kb-elmo/BM42/plates/README.md

# BM42 plate

---

This plate is meant to fit into the BM43 case together with the custom PCB.

The possible layouts are listed below.

#### BM42 plate
bmplate
