kb-elmo/BM42/plates/bm42_plate.dxf

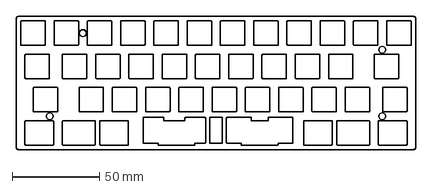
[picture p3: CAD file, 2022-03-03]
plates/bm42_plate.dxf
228.6 x 76.2 mm
