kb-elmo/BM42/pcb/bm42.kicad_sch

## KiCad design pcb/bm42.kicad_sch (2022-03-03)

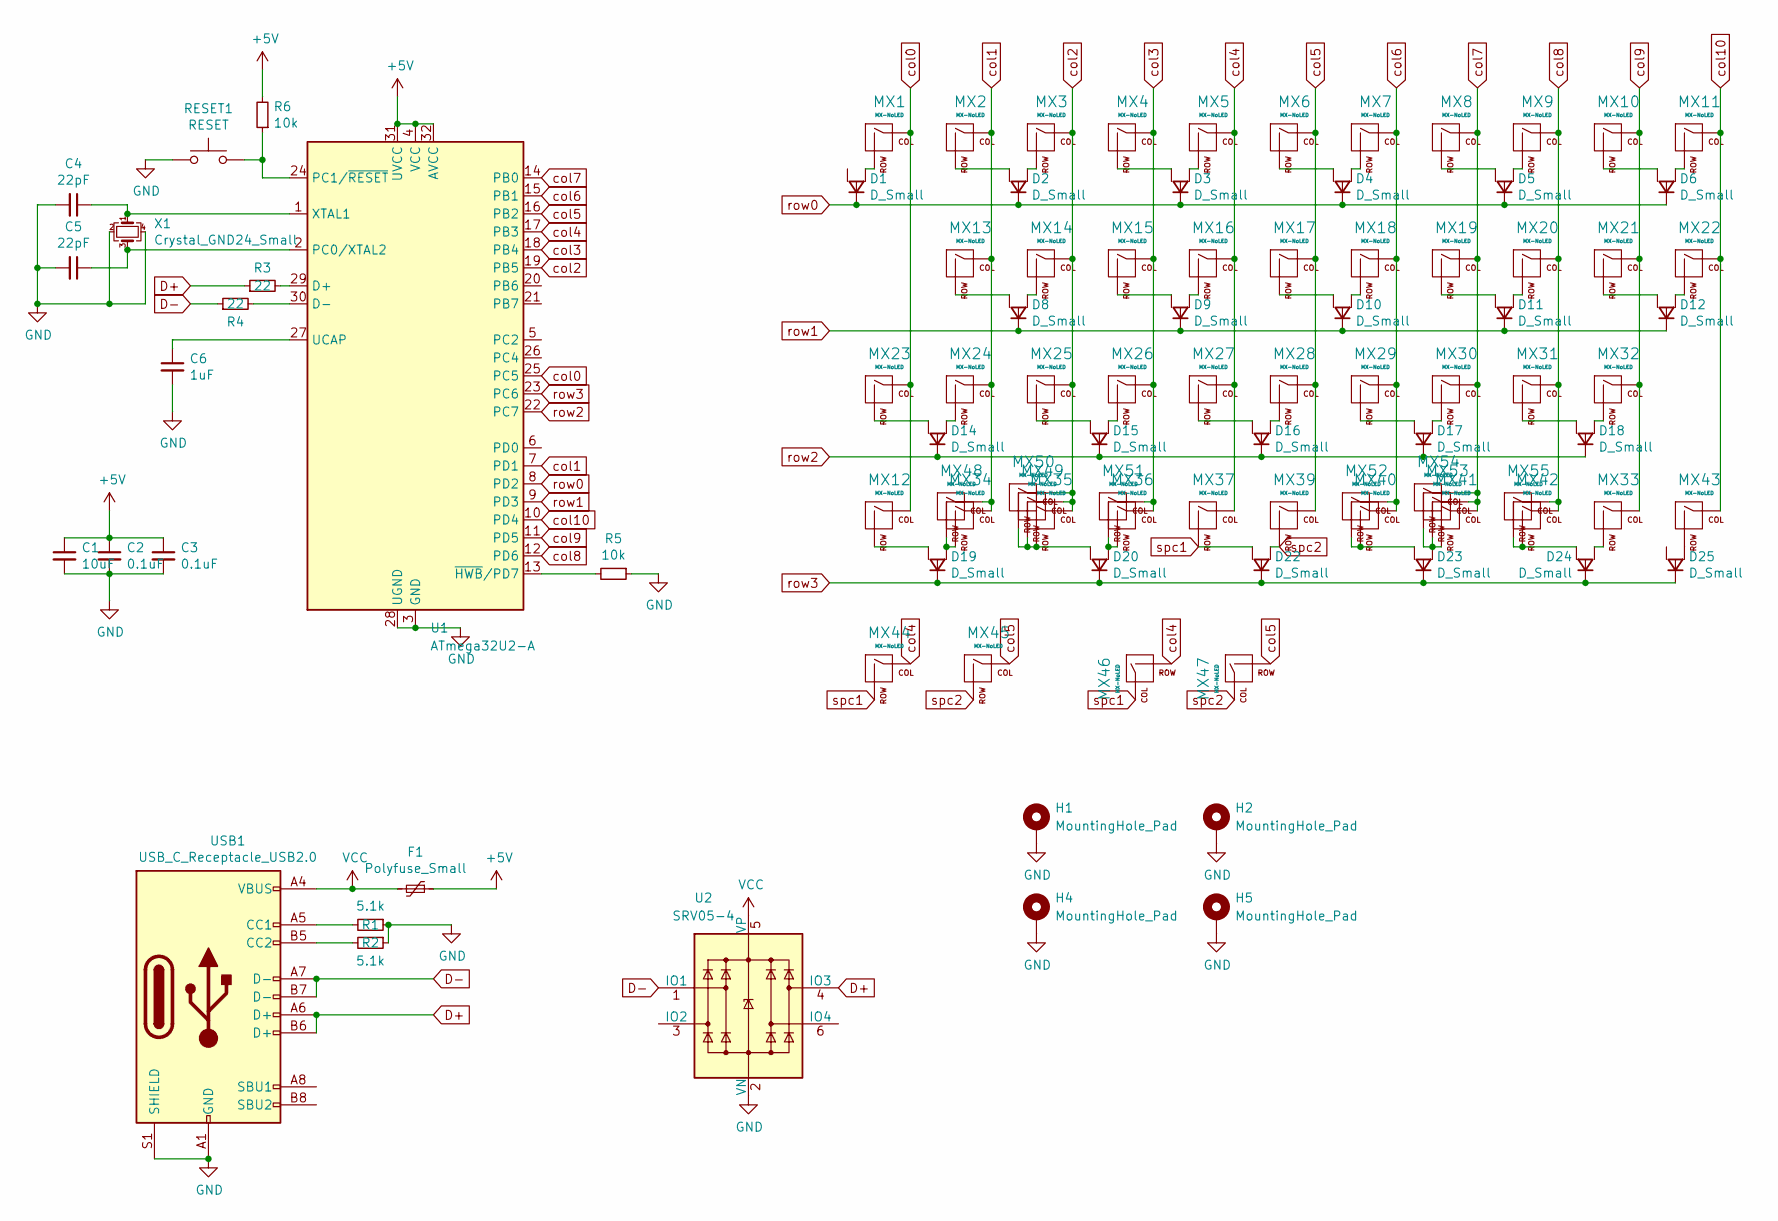
[picture p4: schematic bm42.kicad_sch]

Parts:
C1: 10uF; C_0805_2012Metric; LCSC C91245
C2, C3: 0.1uF; C_0805_2012Metric; LCSC C49678
C4, C5: 22pF; C_0805_2012Metric; LCSC C1804
C6: 1uF; C_0805_2012Metric; LCSC C24123
D1, D2, D3, D4, D5, D6, D8, D9, D10, D11, D12, D14, D15, D16, D17, D18, D19, D20, D22, D23, D24, D25: D_Small; D_SOT-23_ANK_norm; LCSC C68978
F1: Polyfuse_Small; Fuse_1206_3216Metric; LCSC C69688
H1, H2, H4, H5: MountingHole_Pad; MountingHole_2.2mm_M2_DIN965_Pad
MX1, MX2, MX3, MX4, MX5, MX6, MX7, MX8, MX9, MX10, MX11, MX13, MX14, MX15, MX16, MX17, MX18, MX19, MX20, MX21, MX24, MX25, MX26, MX27, MX28, MX29, MX30, MX31, MX32, MX35, MX41, MX43, MX50, MX51, MX52, MX54: MX-NoLED; MXOnly-1U-NoLED
MX12, MX33, MX34, MX36, MX40, MX42, MX49, MX53: MX-NoLED; MXOnly-1.25U-NoLED
MX22, MX23: MX-NoLED; MXOnly-1.75U-NoLED
MX37: MX-NoLED; MXOnly-3U-ReversedStabilizers-NoLED
MX39: MX-NoLED; MXOnly-2U-ReversedStabilizers-NoLED
MX44, MX47: MX-NoLED; MXOnly-2.75U-ReversedStabilizers-NoLED
MX45, MX46: MX-NoLED; MXOnly-2.25U-ReversedStabilizers-NoLED
MX48, MX55: MX-NoLED; MXOnly-1.5U-NoLED
R1, R2: 5.1k; R_0805_2012Metric; LCSC C27834
R3, R4: 22; R_0805_2012Metric; LCSC C17561
R5, R6: 10k; R_0805_2012Metric; LCSC C17414
RESET1: RESET; PinHeader_1x02_P2.54mm_Vertical
U1: ATmega32U2-A; TQFP-32_7x7mm_P0.8mm; LCSC C618733
U2: SRV05-4; SOT-23-6; LCSC C85364
USB1: USB_C_Receptacle_USB2.0; USB_C_Receptacle_HRO_TYPE-C-31-M-12; LCSC C165948
X1: Crystal_GND24_Small; Crystal_SMD_3225-4Pin_3.2x2.5mm; LCSC C13738

Connections:
+5V: C1.1, C2.1, C3.1, F1.1, R6.2, U1.4 (VCC), U1.31 (UVCC), U1.32 (AVCC)
D+: R3.1, U2.4 (IO3), USB1.A6 (D+), USB1.B6 (D+)
D-: R4.1, U2.1 (IO1), USB1.A7 (D-), USB1.B7 (D-)
GND: C1.2, C2.2, C3.2, C4.2, C5.2, C6.2, H1.1, H2.1, H4.1, H5.1, R1.1, R2.1, R5.1, RESET1.1, U1.3 (GND), U1.28 (UGND), U2.2 (VN), USB1.A1 (GND), USB1.A12 (GND), USB1.B1 (GND), USB1.B12 (GND), USB1.S1 (SHIELD), X1.2, X1.4
unnamed: C4.1, U1.1 (XTAL1), X1.1
unnamed: C5.1, U1.2 (PC0/XTAL2), X1.3
unnamed: C6.1, U1.27 (UCAP)
unnamed: D1.3 (A2), MX1.2 (ROW)
unnamed: D2.2 (A1), MX2.2 (ROW)
unnamed: D2.3 (A2), MX3.2 (ROW)
unnamed: D3.2 (A1), MX4.2 (ROW)
unnamed: D3.3 (A2), MX5.2 (ROW)
unnamed: D4.2 (A1), MX6.2 (ROW)
unnamed: D4.3 (A2), MX7.2 (ROW)
unnamed: D5.2 (A1), MX8.2 (ROW)
unnamed: D5.3 (A2), MX9.2 (ROW)
unnamed: D6.2 (A1), MX10.2 (ROW)
unnamed: D6.3 (A2), MX11.2 (ROW)
unnamed: D8.2 (A1), MX13.2 (ROW)
unnamed: D8.3 (A2), MX14.2 (ROW)
unnamed: D9.2 (A1), MX15.2 (ROW)
unnamed: D9.3 (A2), MX16.2 (ROW)
unnamed: D10.2 (A1), MX17.2 (ROW)
unnamed: D10.3 (A2), MX18.2 (ROW)
unnamed: D11.2 (A1), MX19.2 (ROW)
unnamed: D11.3 (A2), MX20.2 (ROW)
unnamed: D12.2 (A1), MX21.2 (ROW)
unnamed: D12.3 (A2), MX22.2 (ROW)
unnamed: D14.2 (A1), MX23.2 (ROW)
unnamed: D14.3 (A2), MX24.2 (ROW)
unnamed: D15.2 (A1), MX25.2 (ROW)
unnamed: D15.3 (A2), MX26.2 (ROW)
unnamed: D16.2 (A1), MX27.2 (ROW)
unnamed: D16.3 (A2), MX28.2 (ROW)
unnamed: D17.2 (A1), MX29.2 (ROW)
unnamed: D17.3 (A2), MX30.2 (ROW)
unnamed: D18.2 (A1), MX31.2 (ROW)
unnamed: D18.3 (A2), MX32.2 (ROW)
unnamed: D19.2 (A1), MX12.2 (ROW)
unnamed: D19.3 (A2), MX34.2 (ROW), MX48.2 (ROW)
unnamed: D20.2 (A1), MX35.2 (ROW), MX49.2 (ROW), MX50.2 (ROW)
unnamed: D20.3 (A2), MX36.2 (ROW), MX51.2 (ROW)
unnamed: D23.2 (A1), MX40.2 (ROW), MX52.2 (ROW)
unnamed: D23.3 (A2), MX41.2 (ROW), MX53.2 (ROW), MX54.2 (ROW)
unnamed: D24.2 (A1), MX33.2 (ROW)
unnamed: D24.3 (A2), MX42.2 (ROW), MX55.2 (ROW)
unnamed: D25.3 (A2), MX43.2 (ROW)
unnamed: R1.2, USB1.A5 (CC1)
unnamed: R2.2, USB1.B5 (CC2)
unnamed: R3.2, U1.29 (D+)
unnamed: R4.2, U1.30 (D-)
unnamed: R5.2, U1.13 (~HWB/PD7)
unnamed: R6.1, RESET1.2, U1.24 (PC1/~RESET)
VCC: F1.2, U2.5 (VP), USB1.A4 (VBUS), USB1.A9 (VBUS), USB1.B4 (VBUS), USB1.B9 (VBUS)
col0: MX1.1 (COL), MX12.1 (COL), MX23.1 (COL), U1.25 (PC5)
col1: MX2.1 (COL), MX13.1 (COL), MX24.1 (COL), MX34.1 (COL), MX48.1 (COL), U1.7 (PD1)
col2: MX3.1 (COL), MX14.1 (COL), MX25.1 (COL), MX35.1 (COL), MX49.1 (COL), MX50.1 (COL), U1.19 (PB5)
col3: MX4.1 (COL), MX15.1 (COL), MX26.1 (COL), MX36.1 (COL), MX51.1 (COL), U1.18 (PB4)
col4: MX5.1 (COL), MX16.1 (COL), MX27.1 (COL), MX37.1 (COL), MX44.1 (COL), MX46.2 (ROW), U1.17 (PB3)
col5: MX6.1 (COL), MX17.1 (COL), MX28.1 (COL), MX39.1 (COL), MX45.1 (COL), MX47.2 (ROW), U1.16 (PB2)
col6: MX7.1 (COL), MX18.1 (COL), MX29.1 (COL), MX40.1 (COL), MX52.1 (COL), U1.15 (PB1)
col7: MX8.1 (COL), MX19.1 (COL), MX30.1 (COL), MX41.1 (COL), MX53.1 (COL), MX54.1 (COL), U1.14 (PB0)
col8: MX9.1 (COL), MX20.1 (COL), MX31.1 (COL), MX42.1 (COL), MX55.1 (COL), U1.12 (PD6)
col9: MX10.1 (COL), MX21.1 (COL), MX32.1 (COL), MX33.1 (COL), U1.11 (PD5)
col10: MX11.1 (COL), MX22.1 (COL), MX43.1 (COL), U1.10 (PD4)
row0: D1.1 (K), D2.1 (K), D3.1 (K), D4.1 (K), D5.1 (K), D6.1 (K), U1.8 (PD2)
row1: D8.1 (K), D9.1 (K), D10.1 (K), D11.1 (K), D12.1 (K), U1.9 (PD3)
row2: D14.1 (K), D15.1 (K), D16.1 (K), D17.1 (K), D18.1 (K), U1.22 (PC7)
row3: D19.1 (K), D20.1 (K), D22.1 (K), D23.1 (K), D24.1 (K), D25.1 (K), U1.23 (PC6)
spc1: D22.2 (A1), MX37.2 (ROW), MX44.2 (ROW), MX46.1 (COL)
spc2: D22.3 (A2), MX39.2 (ROW), MX45.2 (ROW), MX47.1 (COL)
