kb-elmo/BM42/(notices)

Notices in the files:
README.md:
CC BY-NC-SA 4.0
